rjdekker/MHI2MQTT/(threads)

Thread 1 (2018-06-22):

Use ESP8266 only?

rjdekker, 2018-06-22:
I'm getting some questions if it is possible to only use an ESP8266-based board **without** the Arduino.

The thing is that this is what I was aiming for when starting this project. Unfortunately, I could not get SPI communication working with the MHI. The reason is technical and mostly beyond my skills. Running an ESP8266 as a SPI slave (MHI is master) is very poorly documented and some code that I found was impossible for me to get working for this particular scenario.

Some of the things that I ran into:
- The MHI does not use a slave select line and the ESP8266 SPI library does
- The MHI's clock is high when idle. The ESP8266 appears to only work with clock low when idle.
- Cryptic documentation on the ESP's SPI hardware

I still think it's possible but it would cost me too much time to figure out.

In contrast, I had the Arduino working as a SPI slave in no time and the programmatic implementation was delightfully simple compared to the ESP8266.

If anyone knows how to do this, I will be happy to provide you with more detailed information on the SPI protocol.

Cheers, Rob

SwiCago, 2018-07-06:
Hey Rob, awesome job figuring out the protocol for the heavies! I wrote the arduino library for the non_heavy units, based on Hadley's python code. Maybe one day we can do a merge of the two librarys, where a user can choose via #define which protocol to use. But first it would need to work on stand alone ESP.
Since the MHI doesn't use SPI SS, why not just pull it low at all times on ESP. The ESP will be the only slave and that is probably why they didn't add SS pin. Second, you say CLK is low when idle, it is possible that you need to pull it up to 5V with a 10k resistor, since that is what I had to do with my TX/RX lines for bone stock esp01. It seems that Mitsu pins are floating when they are not in use. Good luck and let me know if this helped.

rjdekker, 2018-11-07:
Hi SwiCago,

Great to hear from you and thank you so much for your input. It was actually your work and Hadley’s that inspired me to get something similar going for the MHIs! It works in the current form but it is still far from a mature library that can run on a single ESP.

Your suggestions are a good starting point for further investigation. Unfortunately, I relocated to another city a while ago and left my beloved heavies including the arduinos to the new owner of my old home. I have therefore no access to a unit for testing purposes. My interest will surely return if and when I will install heavies in my new home. Hopefully somebody else can pick this up in the meantime....

Best,

Rob

apateluk, 2019-07-01:
Hi Rob,

I am looking to do an ESP8266 only variant. Can you provide more detail on the SPI protocol if possible please ?

I'm struggling to completly follow the outline High-level protocol you have on the repo home page.

ThomasHFWright, 2020-04-27:
FYI all there is another project now active using only ESP8266 hardware without the arduino requirement https://github.com/absalom-muc/MHI-AC-Ctrl

Thread 2 (2018-10-26):

Question about OTA

nibbler79, 2018-10-26:
Hi,

first, thank you for the great work - I am using your design since 6 Months, without any big issues (controlling 4  MHI SRK via mqtt from fhem)

I just recently noticed that all 4 modules open an hotspot allthough configured and connected.
Is this used for OTA? Or is OTA done via the usual connected WLAN and it is a bug that the hotspot mode comes up in normal "production" mode?

Thank you for your input, and best regards
Markus

rjdekker, 2018-11-07:
Hi Markus,

Great to hear that you got it up and running. I also noticed the open hotspot at some point. However, I relocated to another city a while ago and left the aircons including the arduinos in my old house. So I no longer have access to a working unit for testing what is causing this.

It looks like this is caused by the ESP running in dual mode as described here:
https://github.com/tzapu/WiFiManager/issues/229

Can be solved in the code, but maybe easier to replace the Wifimanager library with this one:
https://github.com/kentaylor/WiFiManager#selectively-operates-in-dual-mode

I hope this version of wifimanager is directly interchangeable with the current ESP2MQTT code.

Let me know if this helps.

Regards,
Rob

Thread 5 (2019-01-22):

Power/Econo mode?

oldwindmill, 2019-01-22:
Good Morning/Afternoon/Evening..
I'm wanting to use something exactly like this to control my 2 MHI aircons.
the larger (model escapes me right now) offers an eco mode which runs in a low power mode. One of the reasons i want to be able to control them is in the event my mains grid fails and i run on battery. - to maximise battery life i first want to reduce to eco mode and then off. Has anyone any idea what bitfields eco mode might use?
(the remote control has a combined power/eco mode - 1 push give power mode, 2 gives eco mode).
I guess i will have to monitor the unit for state change when i manually enter eco mode.

mrgluek, 2019-02-10:
Eco and Power modes separate when trying to use IR codes, but Eco it's just -2.5 (heating) / -1.5 (cooling) from set temperature, so you can just lower the temperature. Power - max/min (heating/cooling) temperature + max fan.

Thread 7 (2019-03-02):

Not respondin

marcosacchetti, 2019-03-02:

marcosacchetti, 2019-03-02:
I solved.

Stephan296, 2019-06-13:
I have the same problem....

marcosacchetti, 2019-06-13:
I’ve tried different brokers and now it works.
I'm using this one: https://www.beebotte.com/

Stephan296, 2019-06-13:
Thx @marcosacchetti . How did you set it up?

Stephan296, 2019-06-13:
@marcosacchetti Do you know this error when compiling MHI-SPI2ESP:

`C:\Users\steph\Downloads\rjdekker-MHI2MQTT-v1.0.0-14-ge737f6e\rjdekker-MHI2MQTT-e737f6e\src\MHI-SPI2ESP\MHI-SPI2ESP.ino: In function 'void SPI_sync()':

C:\Users\steph\Downloads\rjdekker-MHI2MQTT-v1.0.0-14-ge737f6e\rjdekker-MHI2MQTT-e737f6e\src\MHI-SPI2ESP\MHI-SPI2ESP.ino:152:49: warning: invalid conversion from 'volatile void*' to 'void*' [-fpermissive]

   memcpy(&tx_SPIframe[9], &frameVariant[0][0], 9);                                                                 //Copy (part of) the next frame to the current frame for sending on the upcoming bitfield 18 clock cycle

                                                 ^

In file included from C:\Users\steph\Downloads\arduino-1.8.7-windows\arduino-1.8.7\hardware\arduino\avr\cores\arduino/Arduino.h:25:0,

                 from C:\Users\steph\AppData\Local\Temp\arduino_build_956662\sketch\MHI-SPI2ESP.ino.cpp:1:

c:\users\steph\downloads\arduino-1.8.7-windows\arduino-1.8.7\hardware\tools\avr\avr\include\string.h:191:14: note:   initializing argument 1 of 'void* memcpy(void*, const void*, size_t)'

 extern void *memcpy(void *, const void *, size_t);

              ^

C:\Users\steph\Downloads\rjdekker-MHI2MQTT-v1.0.0-14-ge737f6e\rjdekker-MHI2MQTT-e737f6e\src\MHI-SPI2ESP\MHI-SPI2ESP.ino: In function 'void loop()':

C:\Users\steph\Downloads\rjdekker-MHI2MQTT-v1.0.0-14-ge737f6e\rjdekker-MHI2MQTT-e737f6e\src\MHI-SPI2ESP\MHI-SPI2ESP.ino:275:67: warning: invalid conversion from 'volatile void*' to 'const void*' [-fpermissive]

                       memcpy(&toESP.currentMHI, &rx_SPIframe[3], 7);                                               //Copy bitfields 4-10 from the most recent MHI SPI frame to new array for sending to ESP

                                                                   ^

In file included from C:\Users\steph\Downloads\arduino-1.8.7-windows\arduino-1.8.7\hardware\arduino\avr\cores\arduino/Arduino.h:25:0,

                 from C:\Users\steph\AppData\Local\Temp\arduino_build_956662\sketch\MHI-SPI2ESP.ino.cpp:1:

c:\users\steph\downloads\arduino-1.8.7-windows\arduino-1.8.7\hardware\tools\avr\avr\include\string.h:191:14: note:   initializing argument 2 of 'void* memcpy(void*, const void*, size_t)'

 extern void *memcpy(void *, const void *, size_t);

              ^

C:\Users\steph\Downloads\rjdekker-MHI2MQTT-v1.0.0-14-ge737f6e\rjdekker-MHI2MQTT-e737f6e\src\MHI-SPI2ESP\MHI-SPI2ESP.ino:308:62: warning: invalid conversion from 'volatile void*' to 'const void*' [-fpermissive]

                   memcpy(&rx_bitfield4_10, &rx_SPIframe[3], 7);                                                    //Get bitfields 4-10 from the last MHI SPI frame to use for the upcoming tx_SPIframe update

                                                              ^

In file included from C:\Users\steph\Downloads\arduino-1.8.7-windows\arduino-1.8.7\hardware\arduino\avr\cores\arduino/Arduino.h:25:0,

                 from C:\Users\steph\AppData\Local\Temp\arduino_build_956662\sketch\MHI-SPI2ESP.ino.cpp:1:

c:\users\steph\downloads\arduino-1.8.7-windows\arduino-1.8.7\hardware\tools\avr\avr\include\string.h:191:14: note:   initializing argument 2 of 'void* memcpy(void*, const void*, size_t)'

 extern void *memcpy(void *, const void *, size_t);

              ^

C:\Users\steph\Downloads\rjdekker-MHI2MQTT-v1.0.0-14-ge737f6e\rjdekker-MHI2MQTT-e737f6e\src\MHI-SPI2ESP\MHI-SPI2ESP.ino:330:73: warning: invalid conversion from 'volatile void*' to 'void*' [-fpermissive]

               memcpy(&tx_SPIframe[9], &frameVariant[variantnumber][0], 9);                                         //Copy (part of) the next frame to the current frame for sending on the upcoming bitfield 18 clock cycle

                                                                         ^

In file included from C:\Users\steph\Downloads\arduino-1.8.7-windows\arduino-1.8.7\hardware\arduino\avr\cores\arduino/Arduino.h:25:0,

                 from C:\Users\steph\AppData\Local\Temp\arduino_build_956662\sketch\MHI-SPI2ESP.ino.cpp:1:

c:\users\steph\downloads\arduino-1.8.7-windows\arduino-1.8.7\hardware\tools\avr\avr\include\string.h:191:14: note:   initializing argument 1 of 'void* memcpy(void*, const void*, size_t)'

 extern void *memcpy(void *, const void *, size_t);`

marcosacchetti, 2019-06-13:
my configuration:
char mqtt_server[25]     = "mqtt.beebotte.com";
char mqtt_port[9]        = "1883";
char mqtt_user[40]       = "[YOUR_BEEBOTTE_SECRET_KEY]";
char mqtt_pass[20]       = "";
char wifiTimeout[3]      = "5";                                                                                    //Timeout in minutes (max. 99) before WiFi configuration portal is turned off and the ESP tries to connect again to the previously configured AP (if any)
char Room[20]            = "Roomname";
char Thing[20]           = "Aircon";
char Setpoint[60]        = "Setpoint";
char statusSetpoint[60]  = "statusSetpoint";
char State[60]           = "State";
char statusState[60]     = "statusState";
char statusRoomtemp[60]  = "statusRoomtemp";
char Vanes[60]           = "Vanes";
char statusVanes[60]     = "statusVanes";
char Fanspeed[60]        = "Fanspeed";
char statusFanspeed[60]  = "statusFanspeed";
char debug[60]           = "debug";                                                                                //Send only
char service[60]         = "service";

marcosacchetti, 2019-06-13:
I've never found that error compiling... I'm sorry, I can't help you.

Stephan296, 2019-06-13:
I looks like there something wrong with the script. Also with beebotte i don't get any updates.... it looks like that the spi doesn't work right.

marcosacchetti, 2019-06-13:
But I remember that I had a problem with the last version of ArduinoJson library and I needed to do download an old one.

Stephan296, 2019-06-13:
I know that problem, i have used a 5.1 version, can try to download another older one...

marcosacchetti, 2019-06-13:
sometimes it disconnects from the broker but I have a bad connection to the internet, so in my case, the cause could be this

marcosacchetti, 2019-06-13:
I'm trying to do the same with an esp32 without Arduino; if I will succeed, I will let you know.

Stephan296, 2019-06-13:
that would be perfect!!

Stephan296, 2019-06-13:
@marcosacchetti could you only compile the file for me please? To see where the problem is....

Thread 8 (2019-03-02):

Room temperature formula

niclet, 2019-03-02:
Hi,
Thanks for you excellent work.
I'm trying to make it work on ESP8266 directly.
But in my case, the room temperature seems to be not very accurate.
Do you remember why the formula was set to
          //Calculate current room temperature in degrees Celsius from bitfield 7 using:
          // (BF7 - 61) / 4 (note: Calibration of temperature needs to be checked further)
Is it estimated or is there any "reason" for this formula, especially the "- 61" ?
Or does it mean my aircon is not correctly calibrated ?

Best regards.

coyote1, 2019-03-05:
Hi,
did you manage it only with the esp8266?
I have problems with current setup, sometimes connection to MQTT failed and then it can't connect again. I don't know why.
Hope anyone keeps this project alive (maybe you :-)) For tests, I like to make myself available

niclet, 2019-03-05:
Hi,

For now, I have started from scratch.
Since SPI slave seems to be quite undocumented on esp8266, I read MOSI data directly from a simple input pin. For now, I get 20 bytes fields with expected signature, checksum and so on. And in my case (SRK35ZMX-S) the room temperature seems to be quite inaccurate, which led to my question about temperature formula. Maybe the temperature field is just a thermistor value which needs to be used with a temperature table, I don't know. Moreover, since the thermistor is inside the aircon, I don't know how it keeps on getting the correct room temperature while heating.

If you're interested, please take care of voltage, I have burned many components.
MOSI line is ~5V, which is too high for esp8266. I now use a logic level convertor to 3.3V

Still many work :)

mukowman, 2019-03-22:
If you want someone to test I have some NodeMCUs and an MHI AC, willing to test if you want to share your code.

niclet, 2019-03-22:
Thanks :)
For now, since I use software implementation of SPI, I have switched to ESP32 to get 240Mhz. With my ESP8266, even boosted to 160Mhz, I had some frames drop when monitoring CLK rising and falling at the same time.
I'm waiting for my RC-E5 and SC-BIKN-E. It seems that RC-E5 can act as a temperature sensor, which means that we could give our own temperature to the MHI unit instead of using its internal sensor which is quite inefficient to my mind. I hope to improve understanding of the protocol.

niclet, 2019-03-30:
I have received wired remote and interface. I can now monitor CLK, MOSI and MISO correctly.
Next step : analyse MISO temperature from wired remote.

riov, 2019-07-29:
**niclet**, did you managed to get any additional info about the protocol now that you have wired remote and interface? Which exactly remote do you have?

niclet, 2019-08-01:
**riov**, unfortunately, I had not enough time to work correctly on this project, but I will continue as soon as possible.
The remote I use is RC-E5 with interface SC-BIKN-E.
I got them from [https://www.orionairsales.co.uk](url), quite expensive that's why I will work on it for sure :)

riov, 2019-08-01:
**niclet**, unfortunately, you have bought an older wired remote control. It does not support many features like automatic fan speed, control of L/R louvers, hi-power mode and so on.
I have created a program, which allows to analyze MHI's communication protocol. If you have Saleae and need some help, you can contact me.

niclet, 2019-08-02:
Yes, I have a Saleae with 8 pins (official product). Do you analyse data between MHI and interface without remote or do you have another remote control? All help is welcome :)

riov, 2019-08-02:
**niclet**, I intercept data between the AC unit and official WiFi module.
You can send me data captures from Logic, or you can setup Logic server so that I could connect to it and download the data automatically.

niclet, 2019-08-02:
Oh, OK. Do you have a link for the official WiFi module ? Seems I started in wrong direction with the wired remote.

niclet, 2019-08-02:
This item ?
[https://www.aircosuper.nl/Wifi-module-MHI-airco-bediening](url)

niclet, 2019-08-02:
Or [http://www.mitsubishi-electric.co.nz/heatpump/i/69744/wi-fi-interface](url)
But my MHI seems not to be supported (SRK35ZMX-S)

riov, 2019-08-02:
I have this [one](https://www.saturnsales.co.uk/Wi-Fi-Interface-Adaptor.html), and it does support your AC. I am not sure if you will get much more extra insight in MHI's data protocol by purchasing it. Just as your current wired remote control, it does not support many features. The only hope is the latest wired remote control RC-EX3.

niclet, 2019-08-02:
Ok. For now, without Seleae, I already get binary data blocks like this:
6c.80.04.50.00.2a.99.00.00.88.00.ff.ff.ff.ff.ff.00.00.07.86 (from AC to remote, and slightly different from remote to AC)
I already identified some parts by changing settings of the AC from remote.
But temperature (seems to be 7th byte) is not obvious to decode into real °C or °F

riov, 2019-08-03:
Based on the data you have provided, I can say the following about your AC: power is off, mode: Heat, fan speed is ULo, U/D vanes swing, setpoint temp is 21C, room temp is 23C.

niclet, 2019-08-03:
I extract same info from the binary data.
For the room temp, do you use (byte_7 - 61) / 4 formula ?
In this case, it gives 23C, but in some cases, the formula doesn't give exactly the temp displayed on the remote.

niclet, 2019-08-03:
I think I will have to use a hair dryer to create a matching table and try to extract a formula.

riov, 2019-08-03:
Yes, I use the same formula and it looks to be working great in my case. If you can capture a data packet that is giving you a wrong temp, please provide it.
I would be interested in getting longer data captures done with Saleae. There is still a lot of unknown left within this protocol.

riov, 2019-08-07:
**niclet**, do you have any updates? Have you managed to figure out what is wrong with your temp?

niclet, 2019-08-09:
I have used an hair dryer and got following data (byte 7 in hex = displayed temp = formula)
c5 = 34 = 34.00
c2 = 33 = 33.25
bf = 32 = 32.50
ba = 31 = 31.25
b4 = 30 = 29.75
b3 = 30 = 29.50
b1 = 29 = 29.00
b0 = 29 = 28.75
ae = 29 = 28.25
ad = 28 = 28.00
ab = 28 = 27.50
aa = 28 = 27.25
a9 = 27 = 27.00
a7 = 27 = 26.50
a6 = 27 = 26.25
a4 = 26 = 25.75

So formula seems to be quite good.

And while looking at the formula, I was thinking about the conversion between Celsius and Fahrenheit :
T(°C) = (T(°F) - 32) × 5/9

If we consider T(°F) = byte7 / 2, it is nearly the formula.
Unfortunately, when computing values, it is more different that current formula.

But I think it may have a link with F and C.

By the way, the wired remote can't display temperature higher than 35°C even if temperature is higher.

niclet, 2019-08-09:
I will try to switch the wired remote in Fahrenheit to check values.

niclet, 2019-08-09:
Byte7 could also be the direct value of the temperature sensor maybe like a resistor.

niclet, 2019-08-09:
Some temperature samples with remote in Fahrenheit

c0 = 92°F
b9 = 89°F
b7 = 88°F
b6 = 88°F
b4 = 87°F
b3 = 86°F
b1 = 86°F
b0 = 85°F
ae = 84°F
ad = 84°F
ab = 83°F
aa = 82°F
a9 = 82°F
a7 = 81°F
a6 = 81°F
a4 = 80°F
a3 = 79°F
a1 = 78°F
a0 = 78°F
9f = 77°F
9d = 77°F
9c = 76°F

riov, 2019-08-09:
One thing I would like to point out is that you need to let the temperature rest before taking measurements. I was capturing continuous communication with Saleae for long time periods and I have noticed that quite often indoor temp was fluctuating by 0.25 degrees multiple times within one second. What I am trying to say is that it is possible RC-E5 does not update indoor temp value immediately.

The best way to find out how exactly does RC-E5 convert byte 7 to temp would be to connect Arduino directly to it (its interface module) and make it a SPI master. That way you could feed predetermined data and see how it decodes it.

By the way, are you sure your RC-E5 displays air temperature, not its own temperature? [More info](http://airgreencorp.com/documents/procedures/RC-E5%20SENSOR%20SET.pdf).

niclet, 2019-08-09:
For now, I already decode SPI myself with ESP32 and temperature change on the remote occurs really just after a change in the SPI data and remains stable for a while.
I was just thinking about sending my own data to be able to create a full mapping table between data and temperature :)
And yes, my remote is correctly setup to be a thermostat :)

But I have very few time to work on it unfortunately.

riov, 2019-08-11:
Well, it looks like it is a dead end. I was hoping to find out more about this protocol than it is already known. Unfortunately, without having the latest wired remote control it is next to impossible to draw any conclusions about what is really happening apart from stating the obvious, like byte #12 is always `0xFF` and byte #18 is always `0x00`. I do not know how to figure out what is the meaning of those bytes and if they can hold different values.
I was thinking about ordering both RC-EX3 and compatible interface module, so that I could test them out and return within 14 days (I do not really need them). But that would be a huge hassle given that they are not sold locally.

If you find any spare time to build a prototype that allows you to send data directly to your RC-E5 please let us know. Not only it would interesting to see how exactly does room temperature map to byte #7, but it would also be interesting to try out different values for bytes #12, #18 etc. Long data captures made with Saleae would also be helpful.

niclet, 2019-08-11:
Through the wired remote, we can configure many things, like for example : use the temperature sensor of the remote by adding 3° to it. There are many parameters.
When manipulating these parameters, there is a "downloading" step to get current settings from MHI unit. And during this step, bytes 12...16 which are usually FF are modified.

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

riov, 2019-08-11:
I have only observed bytes #13-16 being other than `0xFF`, byte #12 is always the same in my setup.
If you have some spare time, please run Saleae for a few minutes or so and capture what is being sent and received when each option is being changed.

niclet, 2019-08-15:
I have just restarted from scratch with a clean breadboard.
MHI provides 12V power with 5V CLK/MOSI/MISO lines and ESP32 uses 3.3V input/output.
So I use voltage regulators from 12V to 5V and 3.3V to power bidirectional convertors between 5V and 3.3V input/output
Unfortunately, I can spend only few time per day on this project, but I'll do it !! :)
Here is the breadboard, not totally finished yet :)

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

riov, 2019-08-16:
I were you, I would use an external power supply to power those voltage regulators just to be safe.
What about data capture with Saleae, do you intend to do it?

riov, 2019-08-22:
Any updates?

loki-amorf, 2019-08-23:
Thank you for brilliant work!
Now I am doing renovation in my flat, and I am planing to install 2 pcs. SRK20ZS-S with one SCM40ZS-S. When renovation will be done, I going to connect to MHI CNS port and try to control it. I am realy waiting for this moment!

niclet, 2019-08-25:
Unfortunately, no time at all to work on this project past few days. I'll update this thread as soon as I can.

riov, 2019-09-13:
Almost one month has passed since the last update. @niclet, do you have any news?

niclet, 2019-09-19:
I don't forget you. But no time at all for now.

damienmorrissey, 2019-10-21:
Hi all. I too am very interested in assisting wherever I can with this project. I tried to get the original code working- which is an awesome start by the way, but it seemed buggy at times.

If there's anything that I can help with I'm happy to try when I have the time available. I've got three different types, possibly four actually, MHI units.

Thank you all for the hard work!

riov, 2019-10-25:
**@damienmorrissey**, do you have any wired remote controls (e. g. RC-EX3)?

damienmorrissey, 2019-10-25:
Unfortunately no. Only the wireless remote.

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

riov, 2019-10-25:
> Unfortunately no. Only the wireless remote.
Unless someone gets access to the latest wired remote control, there is nothing I can do to investigate communication protocol any further.

damienmorrissey, 2019-10-25:
Ok. Thanks for letting me know.

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

absalom-muc, 2019-11-03:
Since I'm working on a similar project based on rjdekker efforts, I created some documentation for the decoding of a SPI frame [here](https://github.com/absalom-muc/MHI-AC-SPY/blob/master/SPI.md). I can confirm that the formula for the room temperature seems to be correct.

niclet, 2019-11-03:
Hi all,

I have worked a little bit on my installation.
Regarding @absalom-muc work, on my SRK35ZMX-S, the signature for MOSI is 6c.80.04 so it depends on model. And regarding SPI protocol, I get more stable data when looking at CLK falling edge.

I was trying to dynamically modify the MOSI data to check all possible temperature values displayed on my remote, but unfortunately when doing this, the remote displays an error message and the unit shutdowns itself.
I think it will be very difficult to go on this project unfortunately :(

At the early beginning, I wanted to simulate IR remote which is more easy. But there is always this annoying BIP when IR are received on the unit. That's why I wanted to use internal connector.

@riov, does your wifi adaptor works locally, or does it always require an internet connection through an external account (seems to be the case according to the doc I have seen from your link)

I don't think that the RC-EX3 will help us more if the unit shutdowns itself as soon as something suspicious occurs.

absalom-muc, 2019-11-03:
Hi niclet,
> Regarding @absalom-muc work, on my SRK35ZMX-S, the signature for MOSI is 6c.80.04 so it depends on model. And regarding SPI protocol, I get more stable data when looking at CLK falling edge.

There was a mistake in my documentation, my signature is also 0x6c, 0x80, 0x04
I'm surprised that you get more stable data when looking at CLK falling edge, so far, I'm happy with the stability when looking at CLK rising edge. Anyway I'll try it.

riov, 2019-11-03:
>I was trying to dynamically modify the MOSI data

How exactly you was doing that?

>I think it will be very difficult to go on this project unfortunately :(

I am pretty sure you did something wrong. There is no way wired remote control can distinguish whether data is being received from the AC unit or some other device.

>does your wifi adaptor works locally

I had to create an account, download an app for my phone and then log-in in order to be able to control my AC unit.

>I don't think that the RC-EX3 will help us more

I do not agree. You will immediately be able to find out if you can set automatic fan speed, control L/R louvers, set hi-power mode etc.

@absalom-muc, good start. However, there is still plenty of unidentified bits. For example, what does db0[5] mean (it can be both 1 and 0), db2[7] (same) and so on.

niclet, 2019-11-09:
OK, I got it, and I can now test nearly any combination of MOSI frame.
I have restarted my analysis from scratch.
I was previously using interrupt on CLK line to read/write MOSI/MISO, and it was not really stable.
I now permanently read CLK line and guess falling/rising edge myself, and I get a lot more stable results (no errors detected after few hours testing)
@absalom-muc, you are right, MOSI/MISO must be read when CLK rises from 0 to 1.

I have started to test various temperature values to check what is displayed on the remote control.
For example, when temperature byte is set to 0x40, it displays 1°C. So the formula seems to be quite good, but not fully exact (it gives 0°C in this case)
I have also tested 0x30, and it displays 0°C, I think it can't display negative temperatures.
I will give some time to test all possible temperature values.

@riov, I have finally ordered a RC-EX3 on eBay and should get it in some days
The displayed temperature is maybe more precise on the EX3 (half degree maybe)

I will then be able to guess missing bytes (hopefully)

niclet, 2019-11-10:
Ok, so I have tested all possible temperature values.

0°C for all values <= 0x3d
1°C for 0x3e to 0x41 (4 values)
2°C for 0x42 to 0x45 (4 values)
....
34°C for 0xc2 to 0xc5 (4 values)
35°C for all values >= 0xc6

Maybe there will be decimal display of temperature on the RC-EX3.

niclet, 2019-11-10:
According to https://www.mhi-mth.co.jp/en/products/pdf/pjz012a130_english.pdf it seems the RC-EX3 can display outdoor temperature (so it is part of the MOSI frame, and it must be a byte which doesn't fluctuate too much)
But displayed temperatures seem to be integers.

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

riov, 2019-11-10:
> OK, I got it, and I can now test nearly any combination of MOSI frame.

Can you try toggling unknown bits and see what happens? E.g. db0[5] and db2[7]?

> I have finally ordered a RC-EX3 on eBay and should get it in some days

That's fantastic news. I am not sure if your current interface module (SC-BIKN-E) will be fully compatible with RC-EX3 as manufacturer specifies to use a newer version SC-BIKN2-E.

> it seems the RC-EX3 can display outdoor temperature

Yes, you can. It is a part of what I call inner frame, db11.

niclet, 2019-11-10:
> manufacturer specifies to use a newer version SC-BIKN2-E

Yes, I checked that before ordering it, and my interface is a SC-BIKN2-E despite I had ordered a SC-BIKN-E

> Can you try toggling unknown bits and see what happens? E.g. db0[5] and db2[7]?

I'll try to check for db0[5] today.

By the way, I have a doubt on MOSI signature. I might be only the first byte.
On return, only the first byte of the MISO line stays fixed.
Here is an example of two MOSI/MISO frames

6c/a9 80/02 04/77 51/51 22/12 2a/2a a2/ff 00/00 00/00 80/80 00/00 ff/00 ff/f1 ff/f7 ff/ff ff/ff 03/0f 00/00 07/07 ad/23
6c/a9 80/00 04/07 51/51 22/12 2a/2a a2/ff 00/00 00/00 80/80 00/00 ff/00 ff/ff ff/ff ff/ff ff/ff 03/0f 00/04 07/06 ad/cb

riov, 2019-11-10:
In my setup, MOSI frame always starts with 0x6d, 0x80, 0x04 and MISO - 0xa9, 0x00, 0x07.

niclet, 2019-11-10:
Ok, so it may depend on the device connected to the unit. Is your WiFi interface directly connected to the unit ?

riov, 2019-11-10:
Yes.

riov, 2019-11-10:
By the way, you RC-EX3 should come with a CD that has software to control RC-EX3 over the PC. I would really like to get a copy of that software. Could you upload it somewhere once you receive your RC-EX3?

niclet, 2019-11-10:
When I force MOSI db0[5] to 1, nothing changes on the remote display, but on return MISO forces it to 0.

niclet, 2019-11-10:
> By the way, you RC-EX3 should come with a CD that has software to control RC-EX3 over the PC. I would really like to get a copy of that software. Could you upload it somewhere once you receive your RC-EX3?

Sure.

riov, 2019-11-10:
Yes, on returned frame that bit is set to zero (e.g. MOSI - 0x31, MISO - 0x11). Maybe your current wired remote control does not understand it.

riov, 2019-11-10:
It is also interesting, that your remote control will understand 0xae value as 35°C, while in my case it will show 23°C. The last bit has some special meaning.

niclet, 2019-11-10:
Actually, 0xae displays 29°C on my remote.
23°C is displayed for 0x96, 0x97, 0x98 and 0x99.

riov, 2019-11-10:
Sorry, my mistake. I was talking about setpoint temperature (db2[7]). For room temperature: (0xAE - 61) / 4 = 28°C. Not sure why it is off by 1 degree on your control.

niclet, 2019-11-11:
I have just checked that the temperature setpoint is actually
T[°C]=db2[6:0] / 2 instead of T[°C]=db2[6:1]>>2
My remote displays half °C for setpoint, and it matches the least significant bit.

@absalom-muc, you can update it on your side.

riov, 2019-11-11:
So you cannot set your temp in half degree steps with a remote control, but you can do that with wired remote? Have you tried toggling the last bit of db2?

niclet, 2019-11-11:
Setting db0[1] to 0 or 1 doesn't change anything on my remote.

niclet, 2019-11-11:
> So you cannot set your temp in half degree steps with a remote control, but you can do that with wired remote? Have you tried toggling the last bit of db2?

Yes, with IR remote, only full degrees, and with RC-E5, half degrees.

niclet, 2019-11-11:
Setting db2[7] to 0 or 1 doesn't change anything on remote either.
Maybe a useless bit.
Did you ever seen it as 1 during tests ?

riov, 2019-11-11:
> Did you ever seen it as 1 during tests ?

Yes. I have captured it being 0xAE.

riov, 2019-11-11:
You can try different values for db7 and db8. In my setup they are fixed to 0x02 and 0xff.

niclet, 2019-11-11:
db7 is sometimes 0x00 or 0x02 on my side
and db8 is always 0xff too

absalom-muc, 2019-11-11:
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

Thank you niclet, documentation is updated.

niclet, 2019-11-11:
@riov, when you connect the Wifi interface to the connector, is there some kind of init dialog on SPI, or do you get directly stable infos ?

riov, 2019-11-11:
No, it takes quite a long time till I start getting recognizable data.

riov, 2019-11-11:
Actually, it takes ~3 seconds from the moment I stop receiving 0x6d, 0x80, 0x04 and then start receiving it again. During that period crazy stuff is happening. It supposed to be some sort of synchronization process, but I do not not have a clue of what is actually going on.

riov, 2019-11-11:
@niclet, what about my old request to do some data capturing with Saleae? Would you be able to do that? I would like to see communication between your AC unit and your wired remote control.

niclet, 2019-11-12:
I'd rather not modify my installation. But I can provide you some logs like

6c/a9 80/00 04/07 a0/a0 9a/9a ae/ae 9c/ff 00/00 00/00 88/80 00/00 ff/00 ff/ff ff/ff ff/ff ff/ff 00/0f 00/00 08/08 f7/22
6c/a9 80/21 04/07 a0/a0 9a/9a ae/ae 9c/ff 00/00 00/00 88/80 00/00 ff/00 ff/f1 ff/f7 ff/ff ff/ff 00/0f 00/00 08/08 f7/2d
6c/a9 80/00 04/07 a0/a0 9a/9a ae/ae 9c/ff 00/00 00/00 88/80 00/00 ff/00 ff/ff ff/ff ff/ff ff/ff 00/0f 00/04 08/08 f7/26
6c/a9 80/00 04/07 a0/a0 9a/9a ae/ae 9c/ff 00/00 00/00 88/80 00/00 ff/00 ff/ff ff/ff ff/ff ff/ff 00/0f 00/00 08/08 f7/22

riov, 2019-11-12:
I have not seen your latest installation, but if you still use a breadboard, that is as easy as connecting 4 extra wires to Saleae. 4 frames are not enough to draw any conclusions or make any observations. Anyway, I will take a look at it, thanks.

riov, 2019-11-12:
Here are my observations based on the data you have provided:
1. db0[5] bit is set, it does not happen in my setup.
2. db0[7] bit is set, it does not happen in my setup.
3. db1[3] bit is set, it does not happen in my setup.
3. db1[7] bit is set, it does not happen in my setup.
4. db2[7] bit is set.
5. I have not seen MISO signature of 0x09, 0x21, 0x07.

niclet, 2019-11-12:
Ok, I'll take some time to log more data tomorrow.
The RC-EX3 has been dispatched today, hope to get it by the end of the week.

niclet, 2019-11-13:
[Log_from_no_remote_to_stable_remote.txt](https://github.com/rjdekker/MHI2MQTT/files/3842247/Log_from_no_remote_to_stable_remote.txt)

Here you can find full log with following states :
- no remote connected to unit
- remote connected and in "wait" status (synchronisation ?)
- usual mosi/miso communication

riov, 2019-11-13:
Thanks. I will need to investigate further. But right away I can say your "synchronization" sequence is very different from mine. What is happening with constantly changing MISO signature is a big question, it is most of the time being incremented. Are you in any way altering it?

niclet, 2019-11-13:
For now, I never change the MISO line.
And for this log, nothing changed at all.
Maybe the RC-E5 was made for SC-BIKN-E, and not for the SC-BIKN2-E I have.
I don't understand why there would be so much MISO modifications.
There is no need to secure the wire connection.

riov, 2019-11-14:
At the beginning db13 has a value of 7 - never happens in my case, I have only observed it being 0, 1, 3, 5. So, the first three bits have some meaning. Some of you inner frames are unique, I have not seen them. That's all I see different compared to my setup.

What does it all tell us? I guess not much.

loki-amorf, 2019-11-14:
Looks like some setup settings (schedules or temperature ranges) can
download from remote to main unit every time when system starts up.

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

niclet, 2019-11-15:
Still waiting for my new remote, it has arrived in France today, so I should get it in next few days.

By the way, since I have several internal units connected to external unit, I have tested an invalid mode. E.G. one unit is in heat mode, and I power on my spied unit in cool mode, the second one enters "invalid mode"

Here is the data of MOSI/MISO lines during this step

(50 = HEAT OFF)
6c/a9 80/00 04/07 50/50 22/12 28/28 9b/ff 00/00 00/00 88/80 00/00 ff/00 ff/ff ff/ff ff/ff ff/ff 00/0f 00/00 07/06 a8/c4
6c/a9 80/00 04/07 50/50 22/12 28/28 9b/ff 00/00 00/00 88/80 00/00 ff/00 ff/ff ff/ff ff/ff ff/ff 00/0f 00/00 07/06 a8/c4
6c/a9 80/00 04/07 50/50 22/12 28/28 9b/ff 00/00 00/00 88/80 00/00 ff/00 ff/ff ff/ff ff/ff ff/ff 00/0f 00/00 07/06 a8/c4
(49 = COOL ON)
6c/a9 80/00 04/07 49/50 22/12 28/28 9b/ff 00/00 00/00 88/80 00/00 ff/00 ff/ff ff/ff ff/ff ff/ff 01/0f 00/00 07/06 a2/c4
6c/a9 80/00 04/07 49/50 22/12 28/28 9b/ff 00/00 00/00 88/80 00/00 ff/00 ff/ff ff/ff ff/ff ff/ff 01/0f 00/00 07/06 a2/c4
6c/a9 80/00 04/07 49/50 22/12 28/28 9b/ff 00/00 00/00 88/80 00/00 ff/00 ff/ff ff/ff ff/ff ff/ff 01/0f 00/00 07/06 a2/c4

riov, 2019-11-15:
I doubt if that bit means it is in invalid mode. I see that bit often set in my config. Either there are some important uncaptured frames in between HEAT OFF and COOL ON, or, more likely, remote control is clever enough to figure out that you are trying to set Cool mode while AC unit is reporting that it is currently in Heat mode. As an extra step of confirmation, you could try entering and leaving invalid mode several times and see if each time that bit is changing.

I think the way to proceed further is to do some collaboration. If you can find some spare time and if you are willing, we could meet in a chat (current form of communication is not effective) and do real time data recording and analysis.

niclet, 2019-11-15:
There was no missing frame.
I'll take some time to enable/disable this bit inside the MOSI line to check if the remote reacts accordingly.

By the way, my external unit has just been in defrost mode.
Here is the log during this step. I have not analysed it yet at all.

[log_defrost.txt](https://github.com/rjdekker/MHI2MQTT/files/3852844/log_defrost.txt)

riov, 2019-11-15:
I believe, defrost will be byte9, bit2 (your notation).

niclet, 2019-11-16:
> I believe defrost will be byte9, bit2 (your notation).

Actually my log was done during defrost mode, not while going into defrost mode.
So i'm not sure this is byte 9, bit 2.
I don't see specific difference, so there may be a step which tells the defrost begin and another which will tell the defrost end.

riov, 2019-11-16:
Well, you need to try toggling unknown bits in MOSI and see how remote reacts to that. That's
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

Thread 11 (2019-11-12):

Upload error flashing

Kiter1988, 2019-11-12:
Hi,
i try to flash the arduino pro mini with your sketch.

**If I upload the sketch a mistake comes up.**
```
`Arduino: 1.8.10 (Windows 10), Board: "Arduino Pro or Pro Mini, ATmega328P (5V, 16 MHz)"

Der Sketch verwendet 4158 Bytes (13%) des Programmspeicherplatzes. Das Maximum sind 30720 Bytes.
Globale Variablen verwenden 373 Bytes (18%) des dynamischen Speichers, 1675 Bytes für lokale Variablen verbleiben. Das Maximum sind 2048 Bytes.
avrdude: stk500_recv(): programmer is not responding
avrdude: stk500_getsync() attempt 1 of 10: not in sync: resp=0x77
avrdude: stk500_recv(): programmer is not responding
avrdude: stk500_getsync() attempt 2 of 10: not in sync: resp=0x77
avrdude: stk500_recv(): programmer is not responding
avrdude: stk500_getsync() attempt 3 of 10: not in sync: resp=0x77
avrdude: stk500_recv(): programmer is not responding
avrdude: stk500_getsync() attempt 4 of 10: not in sync: resp=0x77
avrdude: stk500_recv(): programmer is not responding
avrdude: stk500_getsync() attempt 5 of 10: not in sync: resp=0x77
avrdude: stk500_recv(): programmer is not responding
avrdude: stk500_getsync() attempt 6 of 10: not in sync: resp=0x77
avrdude: stk500_recv(): programmer is not responding
avrdude: stk500_getsync() attempt 7 of 10: not in sync: resp=0x77
avrdude: stk500_recv(): programmer is not responding
avrdude: stk500_getsync() attempt 8 of 10: not in sync: resp=0x77
avrdude: stk500_recv(): programmer is not responding
avrdude: stk500_getsync() attempt 9 of 10: not in sync: resp=0x77
avrdude: stk500_recv(): programmer is not responding
avrdude: stk500_getsync() attempt 10 of 10: not in sync: resp=0x77
Problem beim Hochladen auf das Board. Hilfestellung dazu unter http://www.arduino.cc/en/Guide/Troubleshooting#upload.

Dieser Bericht wäre detaillierter, wenn die Option
"Ausführliche Ausgabe während der Kompilierung"
in Datei -> Voreinstellungen aktiviert wäre.
`
```
Can anyone explain what I'm doing wrong?

Closed 2019-11-12.

Thread 12 (2019-11-16):

get/send values to the ac

Kiter1988, 2019-11-16:
Hello,
I connected the arduino to my AC (SRK 35 ZS), the light on the esp is on.
It send a connection-message to my broker, every 6 minutes. I visulize it with mqtt.fx
I send help to the device and it sends `{"metrics":[],"seq":0}` back, if i change the "payload decoder".
How can i send some commands to my ac, can you make me an example ?

Only the debug message comes back, nothing else. is that normal ?
I subscribe it all (#)

Im a beginner in this case.

Closed 2019-11-17.

Thread 14 (2020-04-20):

ESP not active when connected to aircon

manoloxxl, 2020-04-20:
Hi,

I'm facing issues with the interface when i connect it to the aircon.

When putting 12V by an external power supply the interface is running (Arduino & ESP all lamps on, connected to wifi)

But when i connect the interface to the aircon just the Arduino is active - the ESP is not showing any LED or connects to the wifi.

I've double checked the wires and CLK Port - everything is fine.

Does anybody has an idea how i can get it working?

Best Regards

Manuel

Closed 2020-04-27.

Thread 15 (2020-04-27):

Random generated MQTT devices with changing chars

manoloxxl, 2020-04-27:
Hi,

I'm running into some issues with the module in my iobroker mqtt instance. After starting up everything is fine - the devices is recognized by the mqtt server and all items are created. Perfect!

But when i'm using the adapter it seems that there is a wrong feedback from the adapter hat creates devices with special chars. Attached a screenshot.

First i was thinking about german special chars (Umlaute) but i only use regular chars. Also debug-mode is of. I think it's issue in the debug feedback. Is there an option to completly deactivate feedback from this part?

Best Regards

Manuel
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

tobiakk, 2020-06-11:
Hi,
Can you tell me how you solved the wiring or settings? I also have the iobroker and the mqtt client but I don't get the status of the air conditioner. the mqtt connection is ok but there are no status entries in the mqtt adapter under objects.

Thanks a lot

manoloxxl, 2020-06-11:
I switched to https://github.com/absalom-muc/MHI-AC-Ctrl

Thread 17 (2021-09-28):

Problem WiFi Setup

PeterPHanlon, 2021-09-28:
I am an old codger from Australia. I am familiar with Arduino, less so with ESP8266. I make the odd Eagle PCB.

I have a few Arduino Mini's, although they don't look identical to your Pro Mini. I also use a MacOSX Big Sur for development.
I have a couple of Adafrruit Huzzah Feather boards. I am interested in the project primarily because I have a large MHI AirCon which is driving me mad, and it does seem to have a lot in common with the environment described.

The documentation provided is terrific, and I have made a lot of progress, but have needed to change things a bit to suit the bits I have.

Firstly Software:  The ESP JSON 6 code needed changing to compile - basically to use JsonDocument class. The changes seem to be a bit simpler than the original, due to Json improvements. I also needed to put a Silabs Driver on the Mac to upload to the Huzzah.

Next Hardware. I had to rework the 2 boards. The Huzzah includes a USB connector, and my Mini is loaded through a FTDI connection. To get access to each board for changing software, and for the connector to the MHI I needed a bit different arrangement. I will send a photo if it might be of general interest. I haven't wired the MHI bit yet, as we are in Covid lockdown.

Anyway, on to the problem. Power to the Huzzah and the Mini is via the USB connector on the Huzzah. Mini LED ON.
I search for a Network, and find one which is obviously the ESP board. But its SSID is ESP_C109E7 and unpassworded.
I don't know how to relate it to my home Wifi SSID/PSWD. I also changed the code temporarily to grab this network.

I do get a nice Wifi Manager screen Config Info Update etc etc, but am unsure on what I should be setting where.
When I upload code into the Huzzah via the SiLabs driver, I don't seem to need any Burnloader activity from the Arduino IDE.

Any comments welcome. Sorry this is a bit preliminary.

Peter Hanlon

PeterPHanlon, 2021-09-29:
Further to the last post, a photo of my setup. I put a 104 cap between the DTR pin on the FTDI line and the R reset pin on the Arduiano Mini. I couldn't get a voltage regulator Pololu but hard-wired an L7805 with a couple of caps. The 5V supply comes from either USB, FTDI, or L7805 Vout and is fed to both boards. Similarly GND. The two jumpers - one side from the Huzzah, and one side from Arduino on both the TX and RX lines. So removing them lets software in either to be uploaded. Underneath it looks like a birds nest or dogs breakfast.
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
